Zylanx/thepaintbrush/hardware/v6/board/production/bom.csv

Designator | Footprint | Quantity | Value | LCSC Part #
PUSH2 | SW_SPST_B3U-1000P | 1 | SW_Push
SW2 | SW_SPDT_PCM12 | 1 | SW_SPDT
