Zylanx/thepaintbrush/hardware/v6/top_plate/production/bom.csv

Designator | Footprint | Quantity | Value | LCSC Part #
H1 | mounting-holes | 1 | MountingHole
