Zylanx/thepaintbrush/hardware/v6/top_plate/small-paintbrush-hotswap-mxplate.step

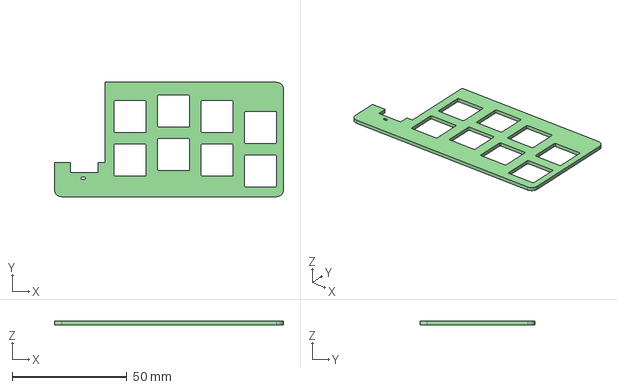
[picture p1: CAD file, 2023-06-16]
hardware/v6/top_plate/small-paintbrush-hotswap-mxplate.step
100.0 x 50.0 x 1.60 mm
