Zylanx/thepaintbrush/hardware/v6/board/small-paintbrush-hotswap.kicad_pcb

## KiCad design hardware/v6/board/small-paintbrush-hotswap.kicad_pcb (2023-06-16)

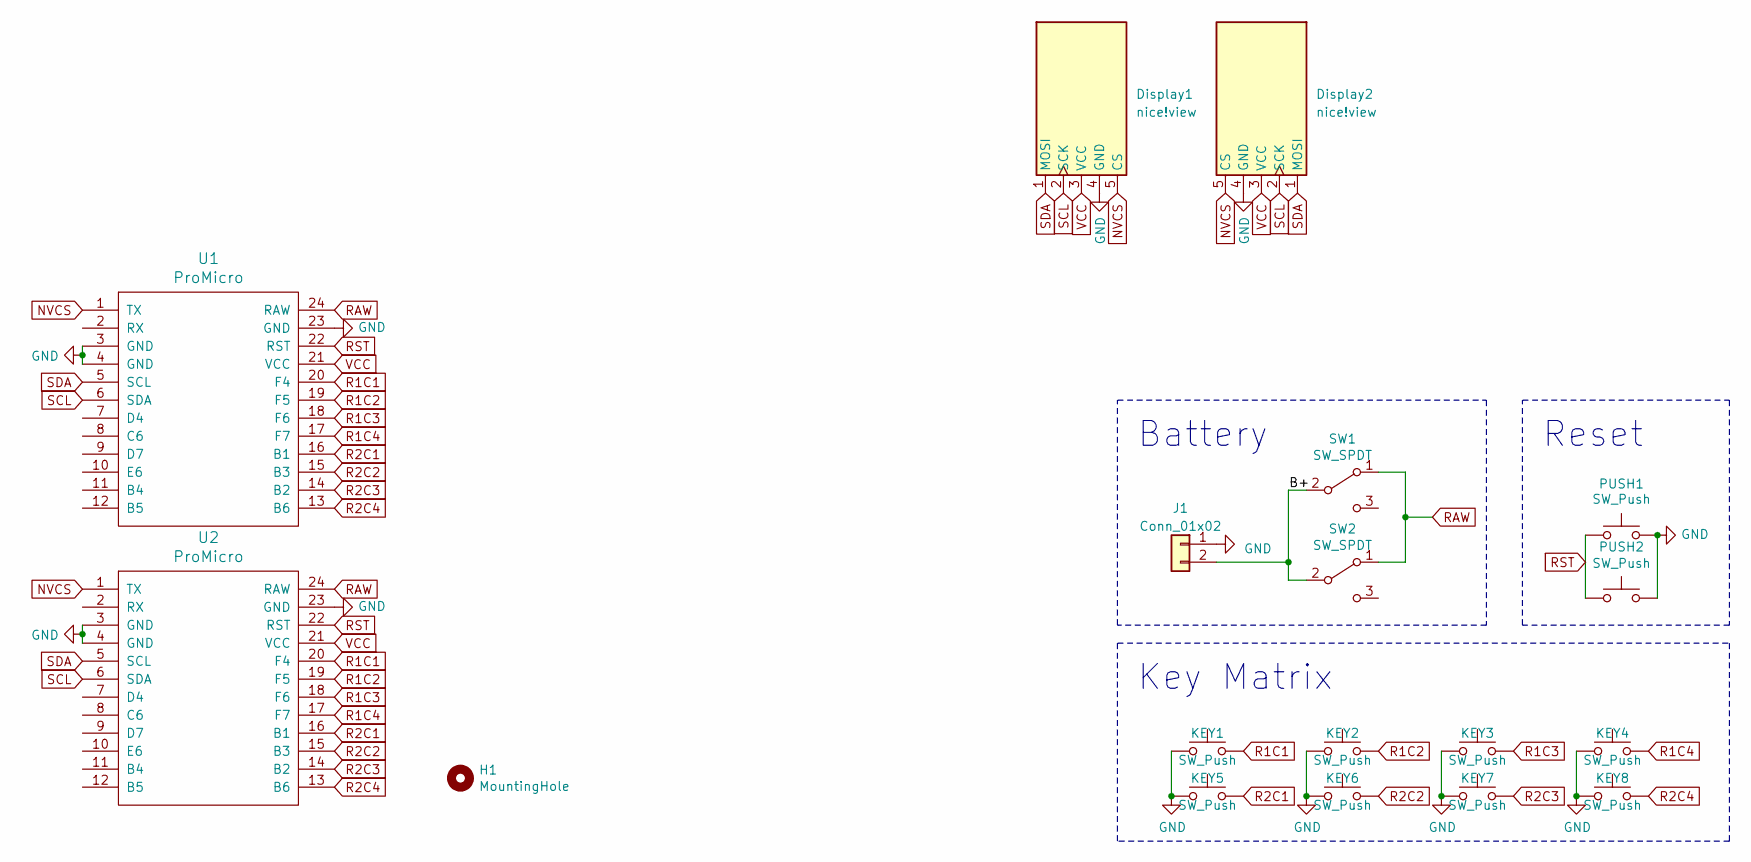
[picture p2: schematic small-paintbrush-hotswap.kicad_sch]

Parts:
Display1, Display2: nice!view; nice_view
H1: MountingHole; mounting-holes
J1: Conn_01x02; PinHeader_1x02_P2.54mm_Vertical
KEY1, KEY2, KEY3, KEY4, KEY5, KEY6, KEY7, KEY8: SW_Push; MX_Choc_Hotswap
PUSH1, PUSH2: SW_Push; SW_SPST_B3U-1000P
SW1, SW2: SW_SPDT; SW_SPDT_PCM12
U1, U2: ProMicro; promicro

Connections:
/B+: J1.2, SW1.2 (B), SW2.2 (B)
GND: Display1.4 (GND), Display2.4 (GND), J1.1, KEY1.1, KEY2.1, KEY3.1, KEY4.1, KEY5.1, KEY6.1, KEY7.1, KEY8.1, PUSH1.2, PUSH2.2, U1.3 (GND), U1.4 (GND), U1.23 (GND), U2.3 (GND), U2.4 (GND), U2.23 (GND)
NVCS: Display1.5 (CS), Display2.5 (CS), U1.1 (TX), U2.1 (TX)
R1C1: KEY1.2, U1.20 (F4), U2.20 (F4)
R1C2: KEY2.2, U1.19 (F5), U2.19 (F5)
R1C3: KEY3.2, U1.18 (F6), U2.18 (F6)
R1C4: KEY4.2, U1.17 (F7), U2.17 (F7)
R2C1: KEY5.2, U1.16 (B1), U2.16 (B1)
R2C2: KEY6.2, U1.15 (B3), U2.15 (B3)
R2C3: KEY7.2, U1.14 (B2), U2.14 (B2)
R2C4: KEY8.2, U1.13 (B6), U2.13 (B6)
RAW: SW1.1 (A), SW2.1 (A), U1.24 (RAW), U2.24 (RAW)
RST: PUSH1.1, PUSH2.1, U1.22 (RST), U2.22 (RST)
SCL: Display1.2 (SCK), Display2.2 (SCK), U1.6 (SDA), U2.6 (SDA)
SDA: Display1.1 (MOSI), Display2.1 (MOSI), U1.5 (SCL), U2.5 (SCL)
VCC: Display1.3 (VCC), Display2.3 (VCC), U1.21 (VCC), U2.21 (VCC)

Notes on the sheet:
Reset
Key Matrix
Battery

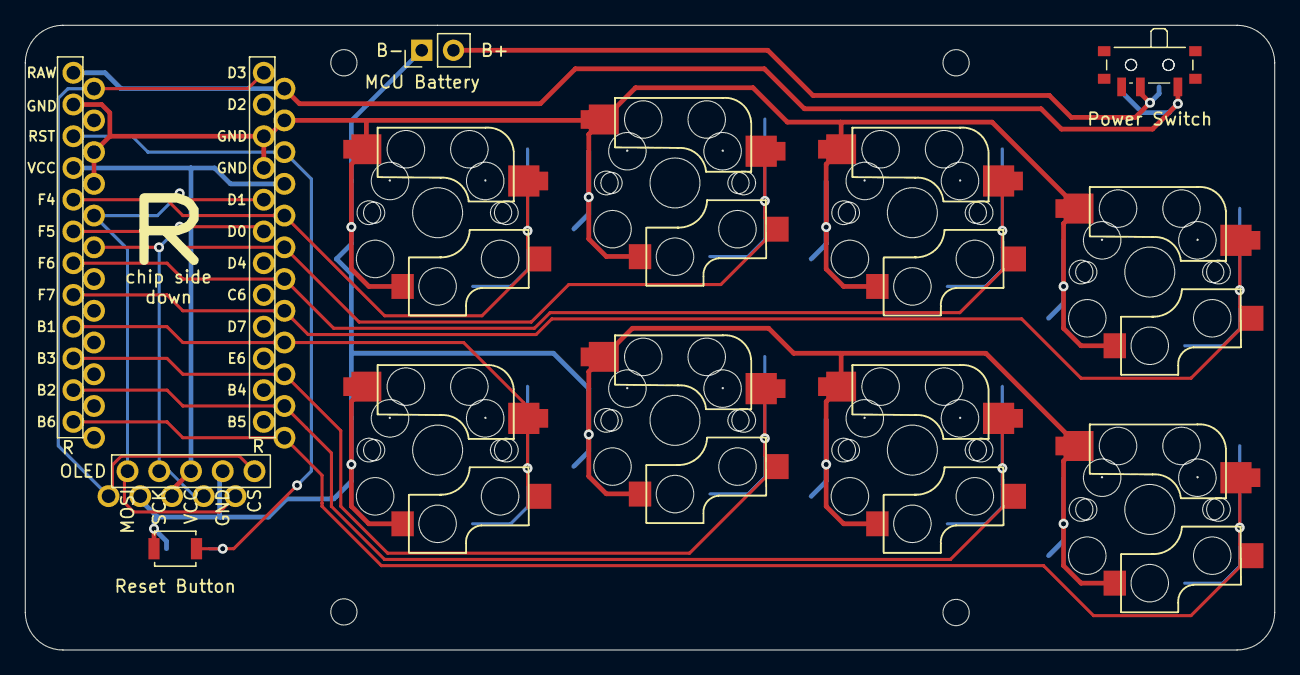
[picture p3: board small-paintbrush-hotswap.kicad_pcb from above]

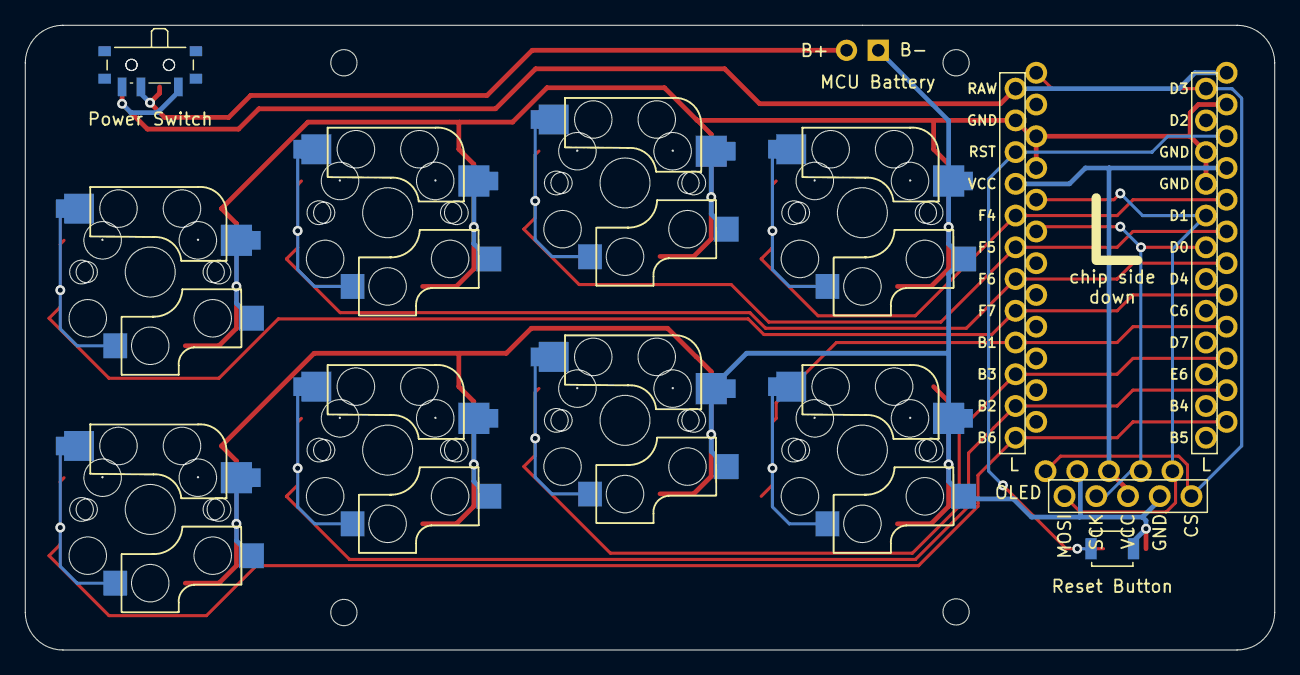
[picture p4: board small-paintbrush-hotswap.kicad_pcb from below]

Board: 2 copper layers, 100.0 x 50.0 mm, 18 parts (4 on the bottom side), 16 nets.
